derrellwilliams/weather-aqi-display/weather_box/enclosure/screen-fit-template.pdf

## Screen / case fit template — actual size

Print at 100% / Actual size. Disable Fit to page.
Check the 100 mm bar with a ruler before comparing parts.
Black: case / aperture. Dashed: physical screen. Gray: reference active area. Compare without bending the panel. Do not cut or press against the glass.

Case: 126 x 82 mm. Window: 93.4 x 57.4 mm.
Physical panel: 105.4 x 62.4 mm. Image reference: 92.8 x 55.68 mm.
Left/right visible borders: 16.3 mm each. Top/bottom: 12.3 mm each.
Image reference is centered in the opening; verify against your actual active pixels. Do this check before attaching the screen with tape.

100 mm reference
