derrellwilliams/weather-aqi-display/weather_box/docs/parts.md

# Parts

**Ordered from seeedstudio.com:**

| Item | SKU | Qty | Role |
|---|---|---|---|
| ePaper Driver Board for Seeed Studio XIAO (V2) | 114993558 | 2 | Adapter board: XIAO socket, 24-pin screen connector, JST battery plug with switch, built-in LiPo charging |
| XIAO ESP32-C3 (Pre-Soldered) | 102010633 | 2 | Wi-Fi microcontroller (the "brain"). Comes with a small U.FL Wi-Fi antenna; attach it. |
| 4.26" Monochrome ePaper, 800×480 | 114993631 | 1 | Main fridge screen |
| 2.9" Quadruple Color ePaper, 128×296 (black/white/red/yellow) | 104990855 | 1 | Experiment: AQI color-coded black, yellow or red. Refreshes in about 25 s, with flicker. |

The second XIAO and driver board are spares, and they also let both screens run at the same time.

**Still to buy elsewhere:**
- 2× 3.7V LiPo battery, **JST-PH 2.0** connector. Plan: **EEMB 963450 1800 mAh** (Amazon), whose listing diagram shows the correct polarity; still check each one on arrival. **Not EEMB B08214DJLJ (2000 mAh):** its polarity is reversed for this board. With the plug's ridged side facing you and the wires pointing down, red must be on the RIGHT.
- Adhesive neodymium magnets
- A USB-C cable that carries data
- A rigid backing for each screen (foamcore, cardboard, or a 3D-printed case)
