derrellwilliams/weather-aqi-display/weather_box/enclosure/print-files/02_electronics_carrier.stl

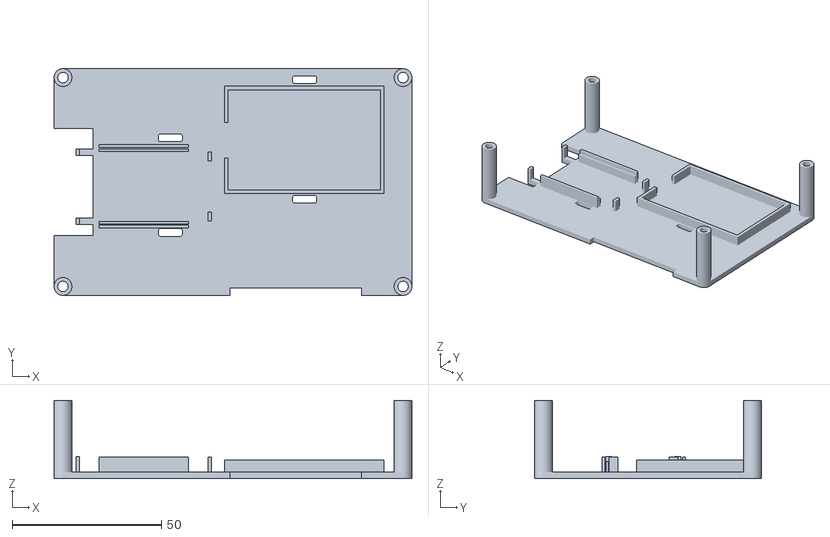
[picture p2: CAD file, 2026-11-13]
weather_box/enclosure/print-files/02_electronics_carrier.stl
120.0 x 76.0 x 26.2
