derrellwilliams/weather-aqi-display/weather_box/enclosure/print-files/03_back.stl

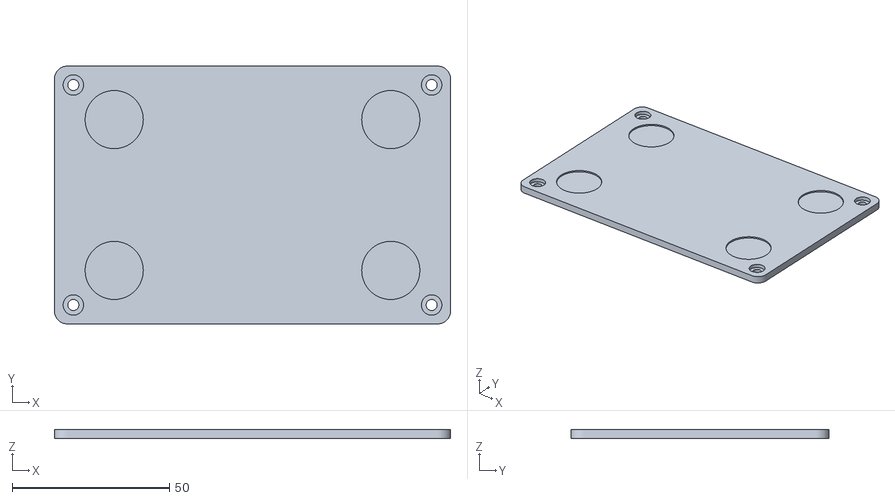
[picture p3: CAD file, 2026-11-13]
weather_box/enclosure/print-files/03_back.stl
126.0 x 82.0 x 3.00
