derrellwilliams/weather-aqi-display/weather_box/enclosure/print-files/optional_fit_coupon.stl

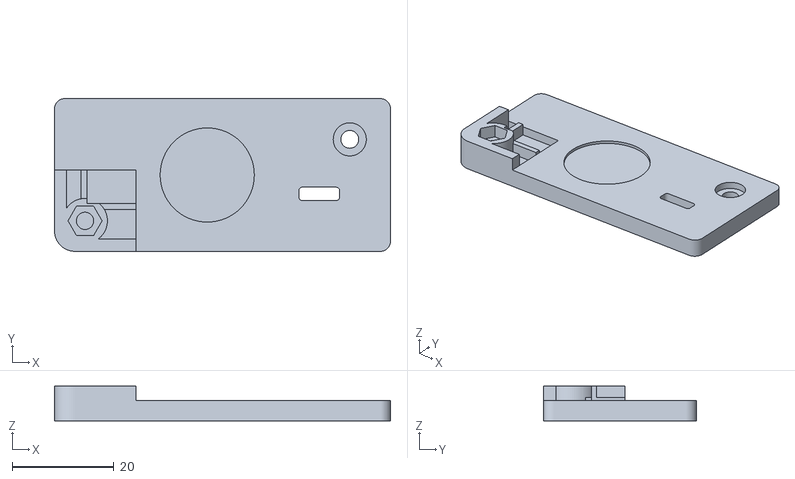
[picture p4: CAD file, 2026-11-13]
weather_box/enclosure/print-files/optional_fit_coupon.stl
66.0 x 30.0 x 6.80
