derrellwilliams/weather-aqi-display/weather_box/enclosure/print-files/01_front_shell.stl

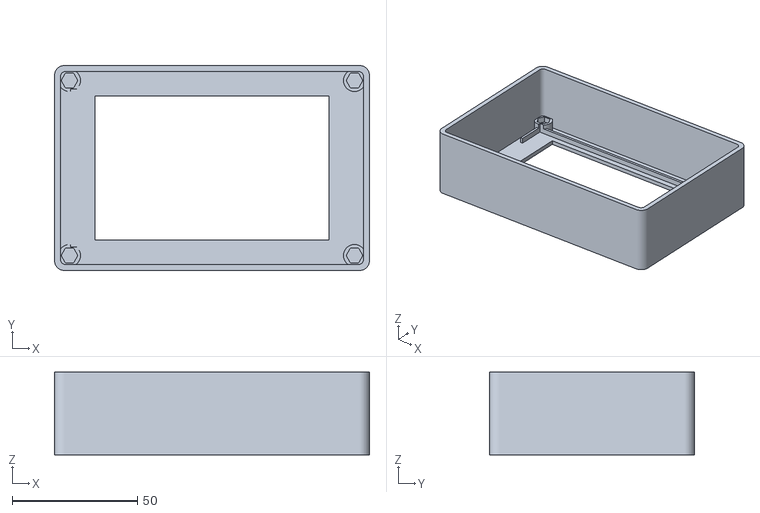
[picture p5: CAD file, 2026-11-13]
weather_box/enclosure/print-files/01_front_shell.stl
126.0 x 82.0 x 33.0
