derrellwilliams/weather-aqi-display/(commit log)

2026-11-02 E-ink fridge display: cloud endpoint and 4.26" firmware
    Cloudflare Worker averages PurpleAir AQI within 5 miles (EPA correction,
    2024 breakpoints) and Open-Meteo weather into ready-to-draw JSON.
    XIAO ESP32-C3 sketch draws a Swiss-style Geist/Phosphor layout and
    deep-sleeps between hourly updates.
    [fridge_4in26.ino, hello_4in26.ino]
2026-11-03 Add flash/serial tools, troubleshooting notes, friendlier precip label
    - firmware/tools/flash.sh and serial.sh: upload-only and read-only serial
    helpers, installed to ~/.local/bin so they can run outside the sandbox
    - CLAUDE.md: build/flash/log workflow, sandbox setup, troubleshooting
    (loose ribbon cable, deep sleep, re-flash after Worker URL change)
    - Worker: show "N% Precip Today" instead of "NO PRECIP"
    - Ignore .claude/settings.local.json
2026-11-04 Switch the screen to Inter with larger type
    Big numbers in Inter Display Bold, bold hourly temps, and labels, header and icons bumped up (21->26, 34->40, 28->34). make_assets.py now builds from Inter's ttf folder; render_preview.py matches the new layout. TEST_MODE back to 0.
2026-11-06 Adjust overnight display sleep to 11:01 PM–4:01 AM
2026-11-13 Move weather/AQI project into weather_box, add enclosure, update paths and docs
    [01_front_shell.stl, 02_electronics_carrier.stl, 03_back.stl, case-review.scad, optional_fit_coupon.stl]
